BCN3D/Hotend-Test-Bench/Gerbers/testbench.TXT

%
M48
M72
T01C0.0120
T02C0.0160
T03C0.0276
T04C0.0400
T05C0.0709
T06C0.1181
T07C0.1260
%
T01
X22620Y20884
X21780Y20884
X23460Y20884
X23040Y20164
X22860Y17524
X20700Y19504
X21060Y19504
X17220Y21004
X17940Y21004
X18660Y21004
X18300Y20404
X17580Y20404
X17340Y18724
X17340Y19384
X1740Y14704
X4980Y13084
X5940Y13144
X2160Y13924
X3120Y13144
X2040Y13144
X4140Y10804
X4560Y10804
X4980Y10804
X5400Y10804
X9840Y10744
X10200Y10744
X10560Y10744
X10920Y10744
X16620Y10804
X17040Y10804
X17460Y10804
X17880Y10804
X22980Y10804
X23340Y10804
X23760Y10804
X24120Y10804
X29820Y10864
X30240Y10864
X30660Y10864
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
