BCN3D/Hotend-Test-Bench/eagle files/testbench.brd

## EAGLE design eagle files/testbench.brd (2015-07-14)

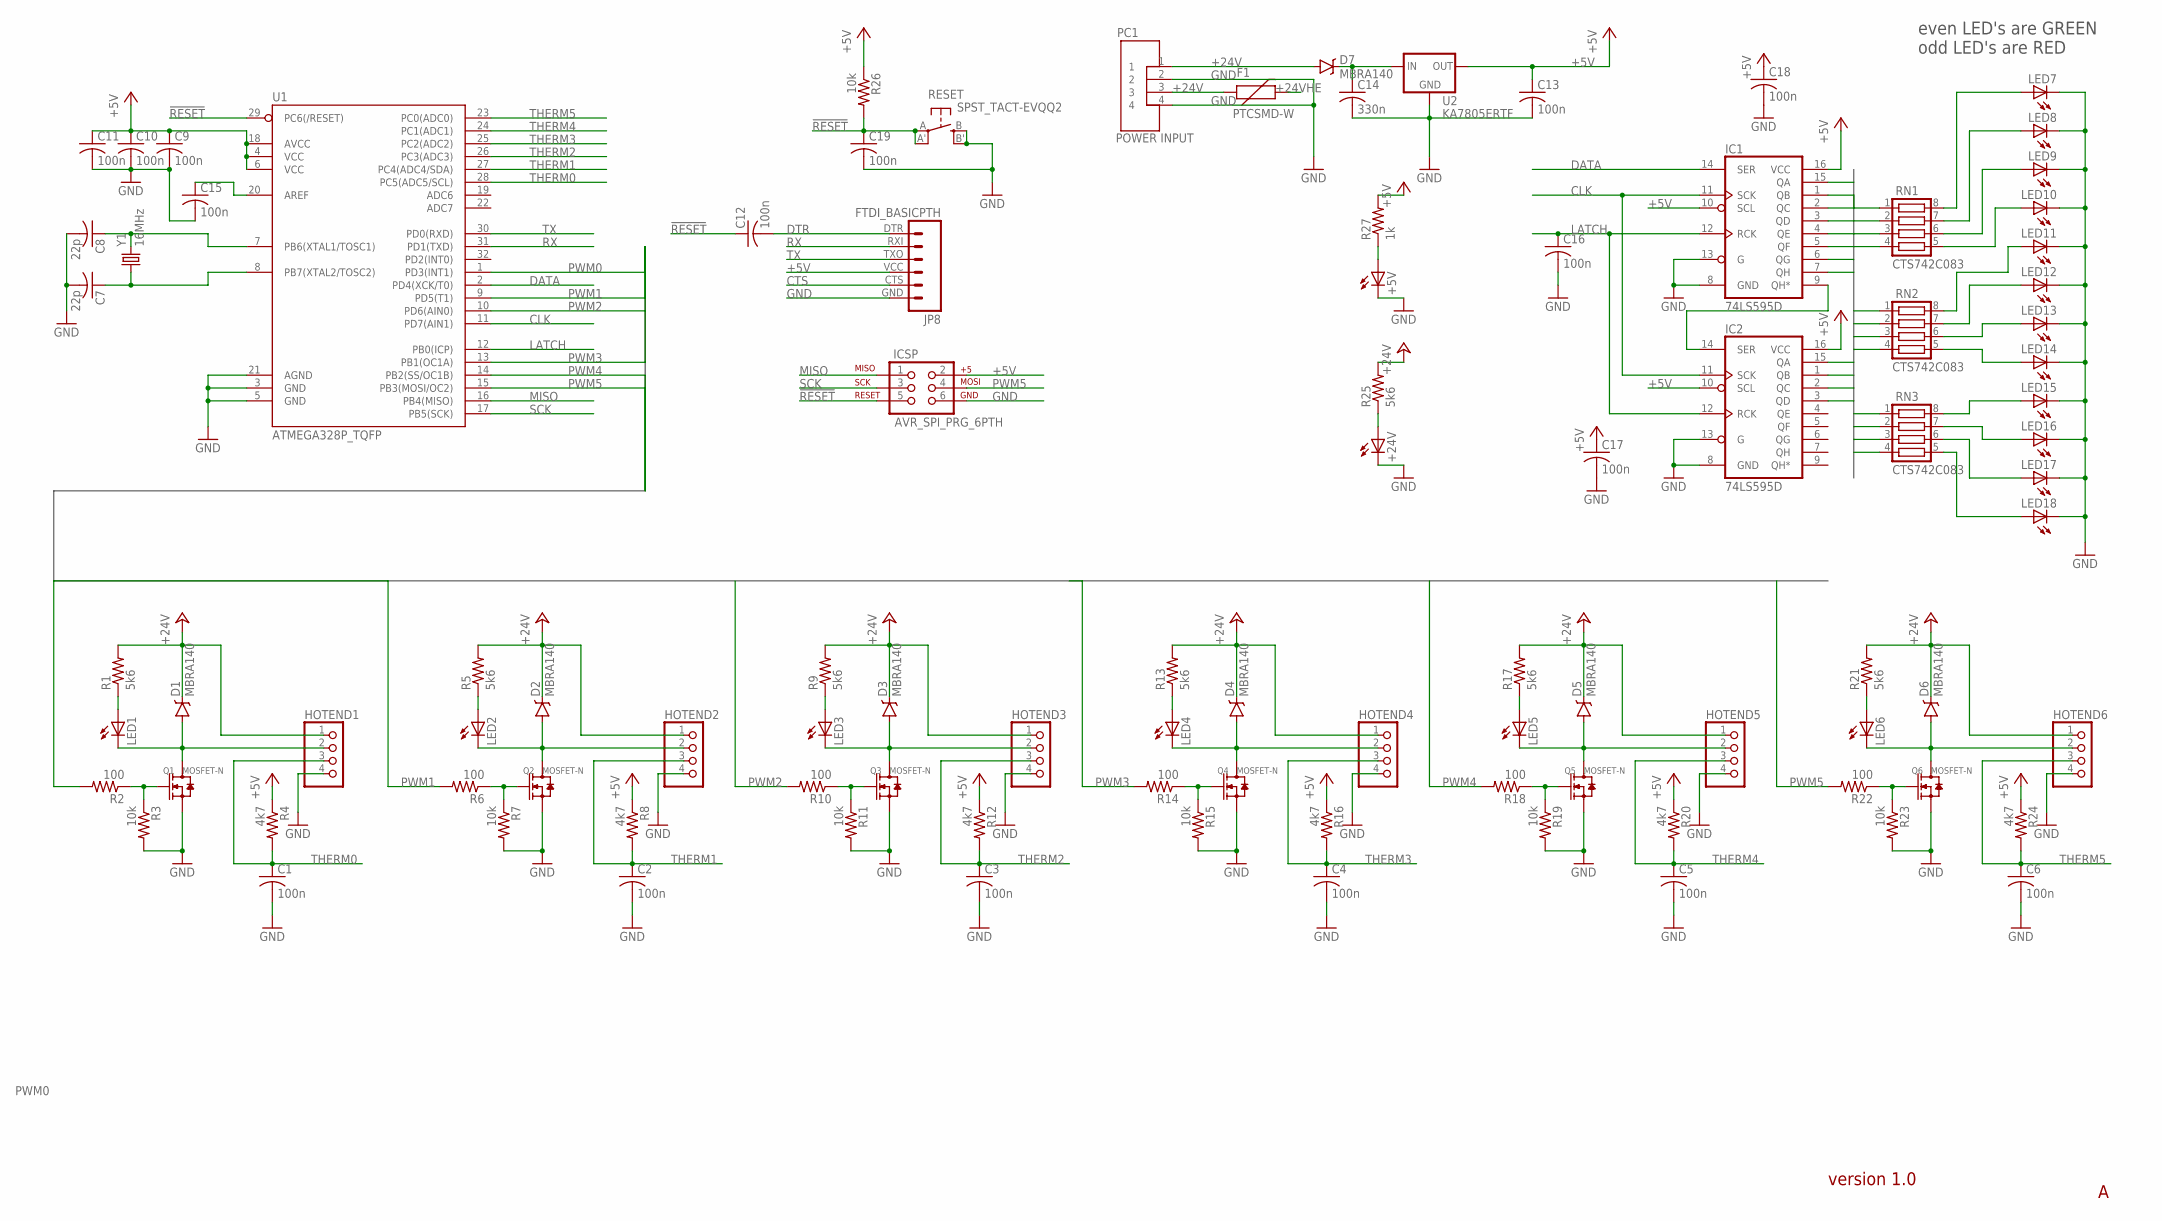
[picture p5: schematic testbench.sch]

Parts:
+5V, +24V: LEDCHIP-LED0805; CHIP-LED0805; MPN OVS-0803
C1, C2, C3, C4, C5, C6, C9, C10, C11, C12, C13, C15, C16, C17, C18, C19: 100n; C0805K; MPN 08051C104KAT2A
C7, C8: 22p; C0805K; MPN 08051A220JAT2A
C14: 330n; C0805K; MPN 08055C334KAT2A
D1, D2, D3, D4, D5, D6, D7: MBRA140; SMA-DIODE; MPN B140-13-F
F1: PTCSMD-W; PTC-1206-WIDE; MPN 3413.0329.22
HOTEND1, HOTEND2, HOTEND3, HOTEND4, HOTEND5, HOTEND6: PINHD-1X4; 1X04
IC1, IC2: 74LS595D; SO16; MPN SN74AHCT595D
ICSP: AVR_SPI_PRG_6PTH; 2X3
JP8: FTDI_BASICPTH; FTDI_BASIC
LED1, LED2, LED3, LED4, LED5, LED6, LED7, LED8, LED9, LED10, LED11, LED12, LED13, LED14, LED15, LED16, LED17, LED18: LEDCHIP-LED0805; CHIP-LED0805; MPN OVS-0803
PC1: POWER INPUT; MOLEX_MINIFIT-JR; MPN 39303045
Q1, Q2, Q3, Q4, Q5, Q6: MOSFET-N; SOIC8; MPN IRF8736PBF
R1, R5, R9, R13, R17, R21, R25: 5k6; R0805; MPN MCWR08X5601FTL
R2, R6, R10, R14, R18, R22: 100; R0805; MPN ERA6AEB101V
R3, R7, R11, R15, R19, R23, R26: 10k; R0805; MPN 0621-013K500-AB103
R4, R8, R12, R16, R20, R24: 4k7; R0805; MPN 1-2176085-7
R27: 1k; R0805; MPN CR0805-JW-102ELF
RESET: SPST_TACT-EVQQ2; EVQ-Q2; MPN EVQQ2503W
RN1, RN2, RN3: CTS742C083
U1: ATMEGA328P_TQFP; TQFP32-08; MPN ATMEGA328-AU
U2: KA7805ERTF; TO-252; MPN KA7805ERTF
Y1: 16MHz; HC49US; MPN 9B-20.000MAAJ-B

Connections:
!RESET: C12.1, C19.1, ICSP.5, R26.2, RESET.A, RESET.A' (P1), U1.29 (PC6(/RESET))
+5V: C9.1, C10.1, C11.1, C13.1, C17.1, C18.1, IC1.10 (SCL), IC1.16 (VCC), IC2.10 (SCL), IC2.16 (VCC), ICSP.2, JP8.VCC (4), R4.1, R8.1, R12.1, R16.1, R20.1, R24.1, R26.1, R27.2, U1.4 (VCC), U1.6 (VCC), U1.18 (AVCC), U2.2 (OUT)
+24V: D7.A, F1.1, PC1.1, PC1.3, R25.2
+24VHE: D1.C, D2.C, D3.C, D4.C, D5.C, D6.C, F1.2, HOTEND1.1, HOTEND2.1, HOTEND3.1, HOTEND4.1, HOTEND5.1, HOTEND6.1, R1.2, R5.2, R9.2, R13.2, R17.2, R21.2
CLK: IC1.11 (SCK), IC2.11 (SCK), U1.11 (PD7(AIN1))
CTS: JP8.CTS (5)
DATA: IC1.14 (SER), U1.2 (PD4(XCK/T0))
DTR: C12.2, JP8.DTR (1)
GND: +5V.C, +24V.C, C1.2, C2.2, C3.2, C4.2, C5.2, C6.2, C7.2, C8.2, C9.2, C10.2, C11.2, C13.2, C14.2, C15.2, C16.2, C17.2, C18.2, C19.2, HOTEND1.4, HOTEND2.4, HOTEND3.4, HOTEND4.4, HOTEND5.4, HOTEND6.4, IC1.8 (GND), IC1.13 (G), IC2.8 (GND), IC2.13 (G), ICSP.6, JP8.GND (6), LED7.C, LED8.C, LED9.C, LED10.C, LED11.C, LED12.C, LED13.C, LED14.C, LED15.C, LED16.C, LED17.C, LED18.C, PC1.2, PC1.4, Q1.1 (S), Q1.2 (S), Q1.3 (S), Q2.1 (S), Q2.2 (S), Q2.3 (S), Q3.1 (S), Q3.2 (S), Q3.3 (S), Q4.1 (S), Q4.2 (S), Q4.3 (S), Q5.1 (S), Q5.2 (S), Q5.3 (S), Q6.1 (S), Q6.2 (S), Q6.3 (S), R3.2, R7.2, R11.2, R15.2, R19.2, R23.2, RESET.B (S), RESET.B' (S1), U1.3 (GND), U1.5 (GND), U1.21 (AGND), U2.3 (GND)
H1: D1.A, HOTEND1.2, LED1.C, Q1.5 (D), Q1.6 (D), Q1.7 (D), Q1.8 (D)
H2: D2.A, HOTEND2.2, LED2.C, Q2.5 (D), Q2.6 (D), Q2.7 (D), Q2.8 (D)
H3: D3.A, HOTEND3.2, LED3.C, Q3.5 (D), Q3.6 (D), Q3.7 (D), Q3.8 (D)
H4: D4.A, HOTEND4.2, LED4.C, Q4.5 (D), Q4.6 (D), Q4.7 (D), Q4.8 (D)
H5: D5.A, HOTEND5.2, LED5.C, Q5.5 (D), Q5.6 (D), Q5.7 (D), Q5.8 (D)
H6: D6.A, HOTEND6.2, LED6.C, Q6.5 (D), Q6.6 (D), Q6.7 (D), Q6.8 (D)
LATCH: C16.1, IC1.12 (RCK), IC2.12 (RCK), U1.12 (PB0(ICP))
LED0: IC1.15 (QA), RN2.4
LED1: IC1.1 (QB), RN2.3
LED2: IC1.2 (QC), RN2.2
LED3: IC1.3 (QD), RN2.1
LED4: IC1.4 (QE), RN1.4
LED5: IC1.5 (QF), RN1.3
LED6: IC1.6 (QG), RN1.2
LED7: IC1.7 (QH), RN1.1
LED8: IC2.15 (QA), RN3.4
LED9: IC2.1 (QB), RN3.3
LED10: IC2.2 (QC), RN3.2
LED11: IC2.3 (QD), RN3.1
MISO: ICSP.1, U1.16 (PB4(MISO))
unnamed: Q1.4 (G), R2.1, R3.1
unnamed: +24V.A, R25.1
unnamed: LED1.A, R1.1
unnamed: Q5.4 (G), R18.1, R19.1
unnamed: C7.1, U1.8 (PB7(XTAL2/TOSC2)), Y1.1
unnamed: LED7.A, RN1.8
unnamed: Q2.4 (G), R6.1, R7.1
unnamed: LED2.A, R5.1
unnamed: Q3.4 (G), R10.1, R11.1
unnamed: LED3.A, R9.1
unnamed: Q4.4 (G), R14.1, R15.1
unnamed: LED4.A, R13.1
unnamed: LED5.A, R17.1
unnamed: Q6.4 (G), R22.1, R23.1
unnamed: LED6.A, R21.1
unnamed: C8.1, U1.7 (PB6(XTAL1/TOSC1)), Y1.2
unnamed: C15.1, U1.20 (AREF)
unnamed: C14.1, D7.C, U2.1 (IN)
unnamed: LED8.A, RN1.7
unnamed: LED9.A, RN1.6
unnamed: LED10.A, RN1.5
unnamed: LED11.A, RN2.8
unnamed: LED12.A, RN2.7
unnamed: LED13.A, RN2.6
unnamed: LED14.A, RN2.5
unnamed: LED15.A, RN3.8
unnamed: LED16.A, RN3.7
unnamed: LED17.A, RN3.6
unnamed: LED18.A, RN3.5
unnamed: IC1.9 (QH*), IC2.14 (SER)
unnamed: +5V.A, R27.1
PWM0: R2.2, U1.1 (PD3(INT1))
PWM1: R6.2, U1.9 (PD5(T1))
PWM2: R10.2, U1.10 (PD6(AIN0))
PWM3: R14.2, U1.13 (PB1(OC1A))
PWM4: R18.2, U1.14 (PB2(SS/OC1B))
PWM5: ICSP.4, R22.2, U1.15 (PB3(MOSI/OC2))
RX: JP8.RXI (2), U1.31 (PD1(TXD))
SCK: ICSP.3, U1.17 (PB5(SCK))
THERM0: C1.1, HOTEND1.3, R4.2, U1.28 (PC5(ADC5/SCL))
THERM1: C2.1, HOTEND2.3, R8.2, U1.27 (PC4(ADC4/SDA))
THERM2: C3.1, HOTEND3.3, R12.2, U1.26 (PC3(ADC3))
THERM3: C4.1, HOTEND4.3, R16.2, U1.25 (PC2(ADC2))
THERM4: C5.1, HOTEND5.3, R20.2, U1.24 (PC1(ADC1))
THERM5: C6.1, HOTEND6.3, R24.2, U1.23 (PC0(ADC0))
TX: JP8.TXO (3), U1.30 (PD0(RXD))

Notes on the sheet:
even LED's are GREEN odd LED's are RED
version 1.0

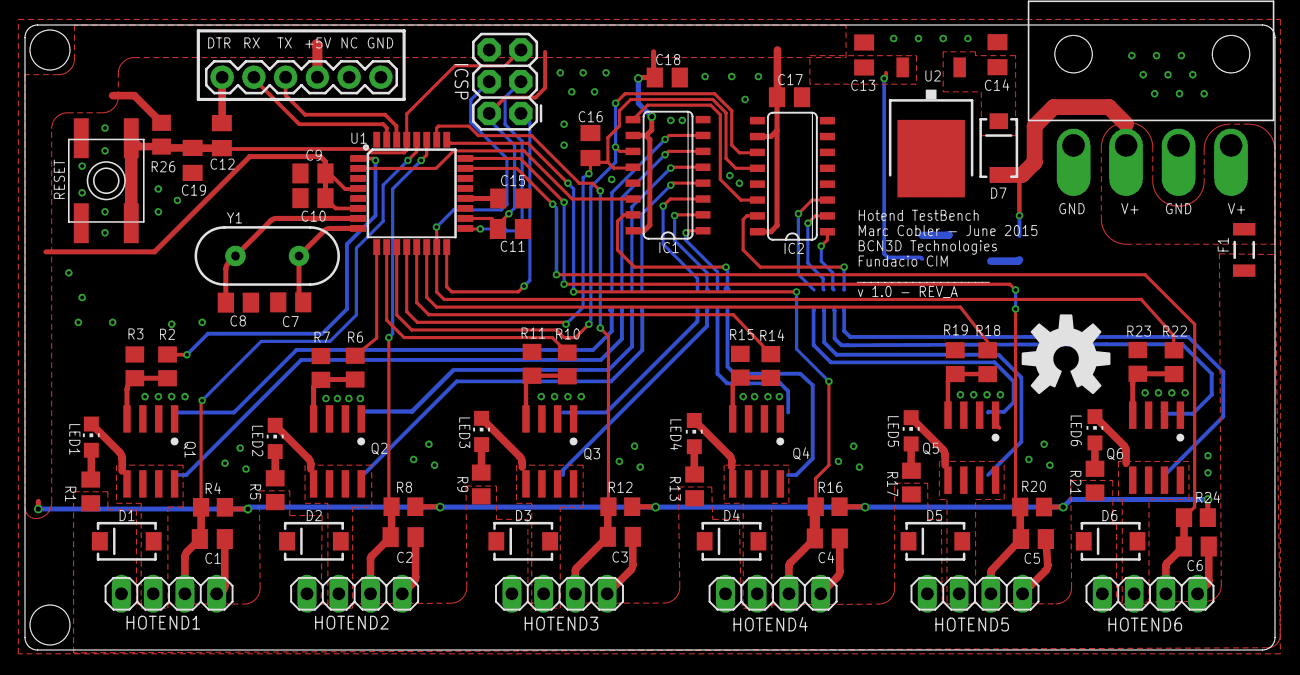
[picture p6: board testbench.brd from above]

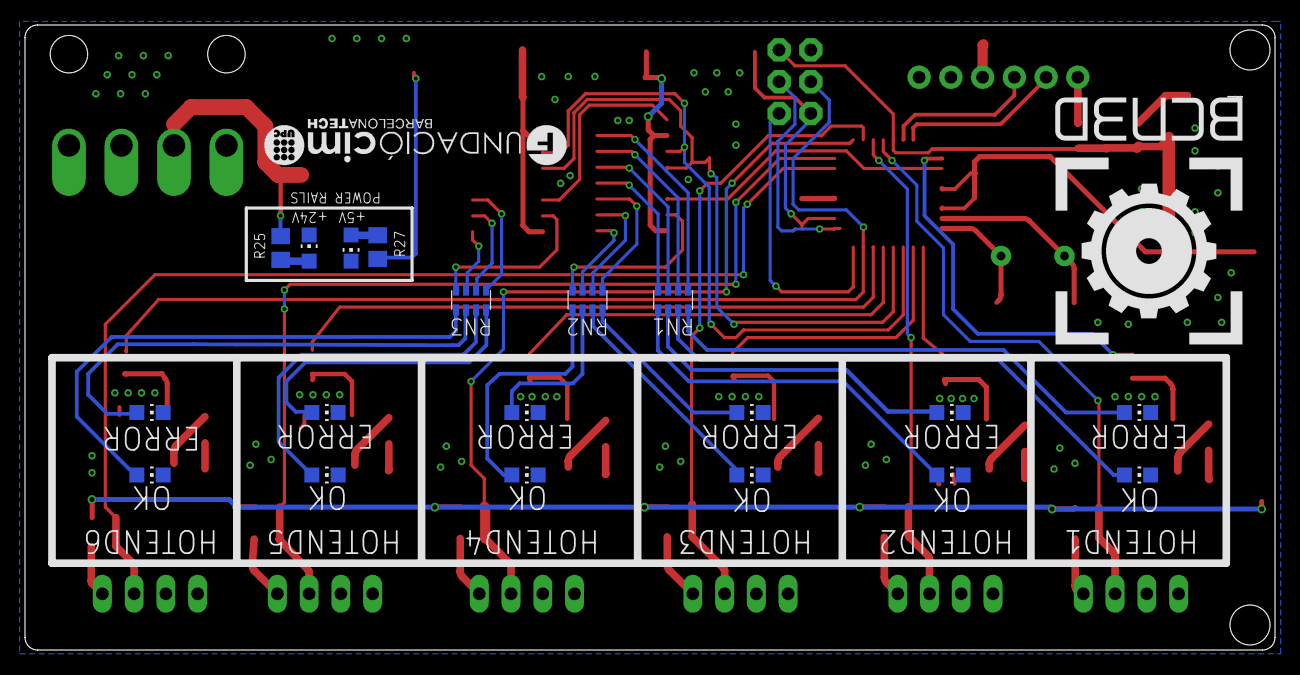
[picture p7: board testbench.brd from below]

Board: 2 copper layers, 100.0 x 50.0 mm, 101 parts (21 on the bottom side), 74 nets.

Other parts of the board:
U$1: FCIM_LOGO
U$2: BCN3D_LOGO
U$3: OSHW-LOGO-L
