BCN3D/Hotend-Test-Bench/Code/hotend.h

/*---------------------------------------------------------------------
hotend.h - Hotend Public class
HotEnd test Jig
Marc Cobler Cosmen - June 2015
BCN3D Technologies - Fundacio CIM

This program is for testing the assembled hotends in BCN3D Technologies.
It's Atmega328 based and it contains 6 power Mosfet Channels to heat up
6 hotends at a time. If the heating curve is within limits, then a Green
LED lights up, if not a red LED lights up.

----------------------------------------------------------------------*/
#include "Arduino.h"
//Make this values dependant on the input from the user. This will let us test other types of hotends.
#define NUMSAMPLES 5
#define SERIESRESISTOR 4700
#define TEMPERATURENOMINAL 25
#define THERMISTORNOMINAL 100000
#define BCOEFFICIENT 3950
#define MAXTEMPERATURE 260
#define MEANHEATINGTIME 60000	//Mean time that takes to heat the extruder
#define MARGINERROR 0.15

class hotend
{
//Class Member Variables initialized at startup
int heaterPin;					//Heater PWM Pin
int thermistorPin;				//Thermistor pin
unsigned long startTime, stopTime;
int tempSamples[NUMSAMPLES];	//Array of temp samples


//Constructor of the class - Creates a Hotend
//Initializes the member variables and state
public:
double gap;
bool state;
double averageTemp;				//Average Temp calculated from samples
double tempCelsius;				//Degrees celsius value
bool hotendState;
unsigned long timeToHeat;

hotend(int therm,int heater) {
	heaterPin = heater;
	thermistorPin = therm;
	pinMode(heaterPin, OUTPUT);
	startTime = millis();
	stopTime = 0;
	timeToHeat = 0;
	averageTemp = 0;
	tempCelsius = 0;
	state = 0; //State 0 for heating and 1 for cooling
	hotendState = false; //State true for correct hotends and false for defective
	
}
void readTemperature() {
	uint8_t i;			//iterator for the temp array
	//Get the samples
	for (i = 0; i < NUMSAMPLES; i++)
	{
		tempSamples[i] = analogRead(thermistorPin);		
		delayMicroseconds(1000);
	}
	//Average all the samples
	averageTemp = 0;
	for (i = 0; i < NUMSAMPLES;  i++)
	{
		averageTemp += tempSamples[i];
	}
	averageTemp = averageTemp / NUMSAMPLES;
	//Convert the Analog value to resistance
	averageTemp = 1023 / averageTemp - 1;
	averageTemp = SERIESRESISTOR / averageTemp;
	//Serial.print("Therm Resistance: ");
	//Serial.println(averageTemp);
	
	//Convert to Celsius
	tempCelsius = averageTemp / THERMISTORNOMINAL;		// (R/Ro)
	tempCelsius = log(tempCelsius);						// ln(R/Ro)
	tempCelsius /= BCOEFFICIENT;						//1/B * ln(R/Ro)
	tempCelsius += 1.0 / (TEMPERATURENOMINAL + 273.15);	//+ (1/To)
	tempCelsius = 1.0 / tempCelsius;					//Invert
	tempCelsius -= 273.15;								//Convert to Celsius from Kelvin
}
bool manageTime() {
	stopTime = millis();
	Serial.println(stopTime);
	startTime += 250;	//Add the 0.25 seconds delay and a margin
	Serial.println(startTime);
	timeToHeat = stopTime - startTime;
	Serial.println(timeToHeat);
	if (timeToHeat >= MEANHEATINGTIME*(1-MARGINERROR) && timeToHeat <= MEANHEATINGTIME*(1+MARGINERROR))
	{
		//Timing is correct so GREEN LED
		return true;
	} else {
		//Timing is incorrect so RED LED 
		return false;
	}
	//Store the time taken to heat up somehow and the correct/fail ratio
}

void update(double output) {	
	if (state == 0)	//Heating
	{
		//Serial.println("Heating...");
		gap = abs(MAXTEMPERATURE - tempCelsius);
		if (gap < 2.0 || tempCelsius > MAXTEMPERATURE)
		{
			//Serial.println("Temperature Reached!");
			//setTemperature Reached. Cooling state
			state = 1;
			//Manage time
			hotendState = manageTime();
		} else {
			//Serial.print("Heating at: ");
			//Serial.println(output);
			analogWrite(heaterPin, output);
		}
			
	} else {		//Cooling
		//Serial.println("Cooling...");
		analogWrite(heaterPin, 0);
	}

}
//protected:
//private:
};
