BCN3D/Hotend-Test-Bench/(commit log)

2015-06-16 Version 0.9 of the Board
    First stable version of the Extruder test jig. Waiting for the PCB's to
    be manufactured
    [testbench.brd, testbench.sch]
2015-06-22 v 1.0 - REV_A
    You can find all the gerbers and the BOM. Sent to Fab House.
    [BOM.xlsx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]
2015-07-14 All the code for the Hotend Test Jig!
    Updated BOM
    All the code, untested yet
    Updated crystal frequency
    [BOM.xlsx, testbench.brd, testbench.sch]
2015-11-13 changes in file tree and updates
    Now we have a tested stable version. The PID values are not tuned yet.
2015-11-13 update file tree and Processing
    New Processing sketch that plots the temperature of the hotends to fine
    tune the PID and to check for differences.
    [testbench.brd, testbench.sch]
2015-11-17 securityBlink()
    this functions tells you through the leds if you can hold the hotend
    depending on the temperature
2015-11-18 New COM Port Selection screen
    Before the graph it lets you select the correct COM Port and connect to
    the board
    [TemperaturesPlotter.java, TemperaturesPlotter.pde]
2015-11-23 Splash screen now working
    Added descriptions of functions and some bug fixes
    [TemperaturesPlotter.pde]
2015-11-24 Change the PID Values and the target temperature.
2016-11-04 Print Settings @ startup and some corrections
    [Code.ino, hotend.h]
2017-05-18 Minor corrections and updates!
    [Code.ino, hotend.h]
